RollMan/ac_onoff_controller/README.md

## Appearance
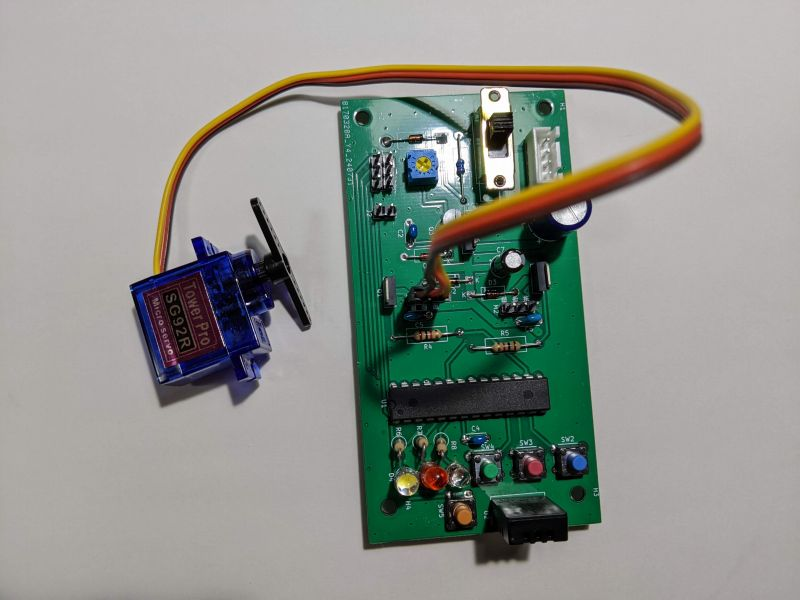
[picture p1: docs/img/board_fig.jpg]
Board appearance


## Improvements
The 2nd servo motor (M2) must be connected to PB2 which is assigned as compare output mode.
