RollMan/ac_onoff_controller/bypass_capacitor.asc

C1: cap; 500µ
I1: current; 0.5
Named nets: 0
.tran 0.01
.ic V(N001) 5
