RollMan/ac_onoff_controller/hardware/ac_onoff_controller/ac_onoff_controller.kicad_pcb

## KiCad design hardware/ac_onoff_controller/ac_onoff_controller.kicad_pcb (2024-07-31)

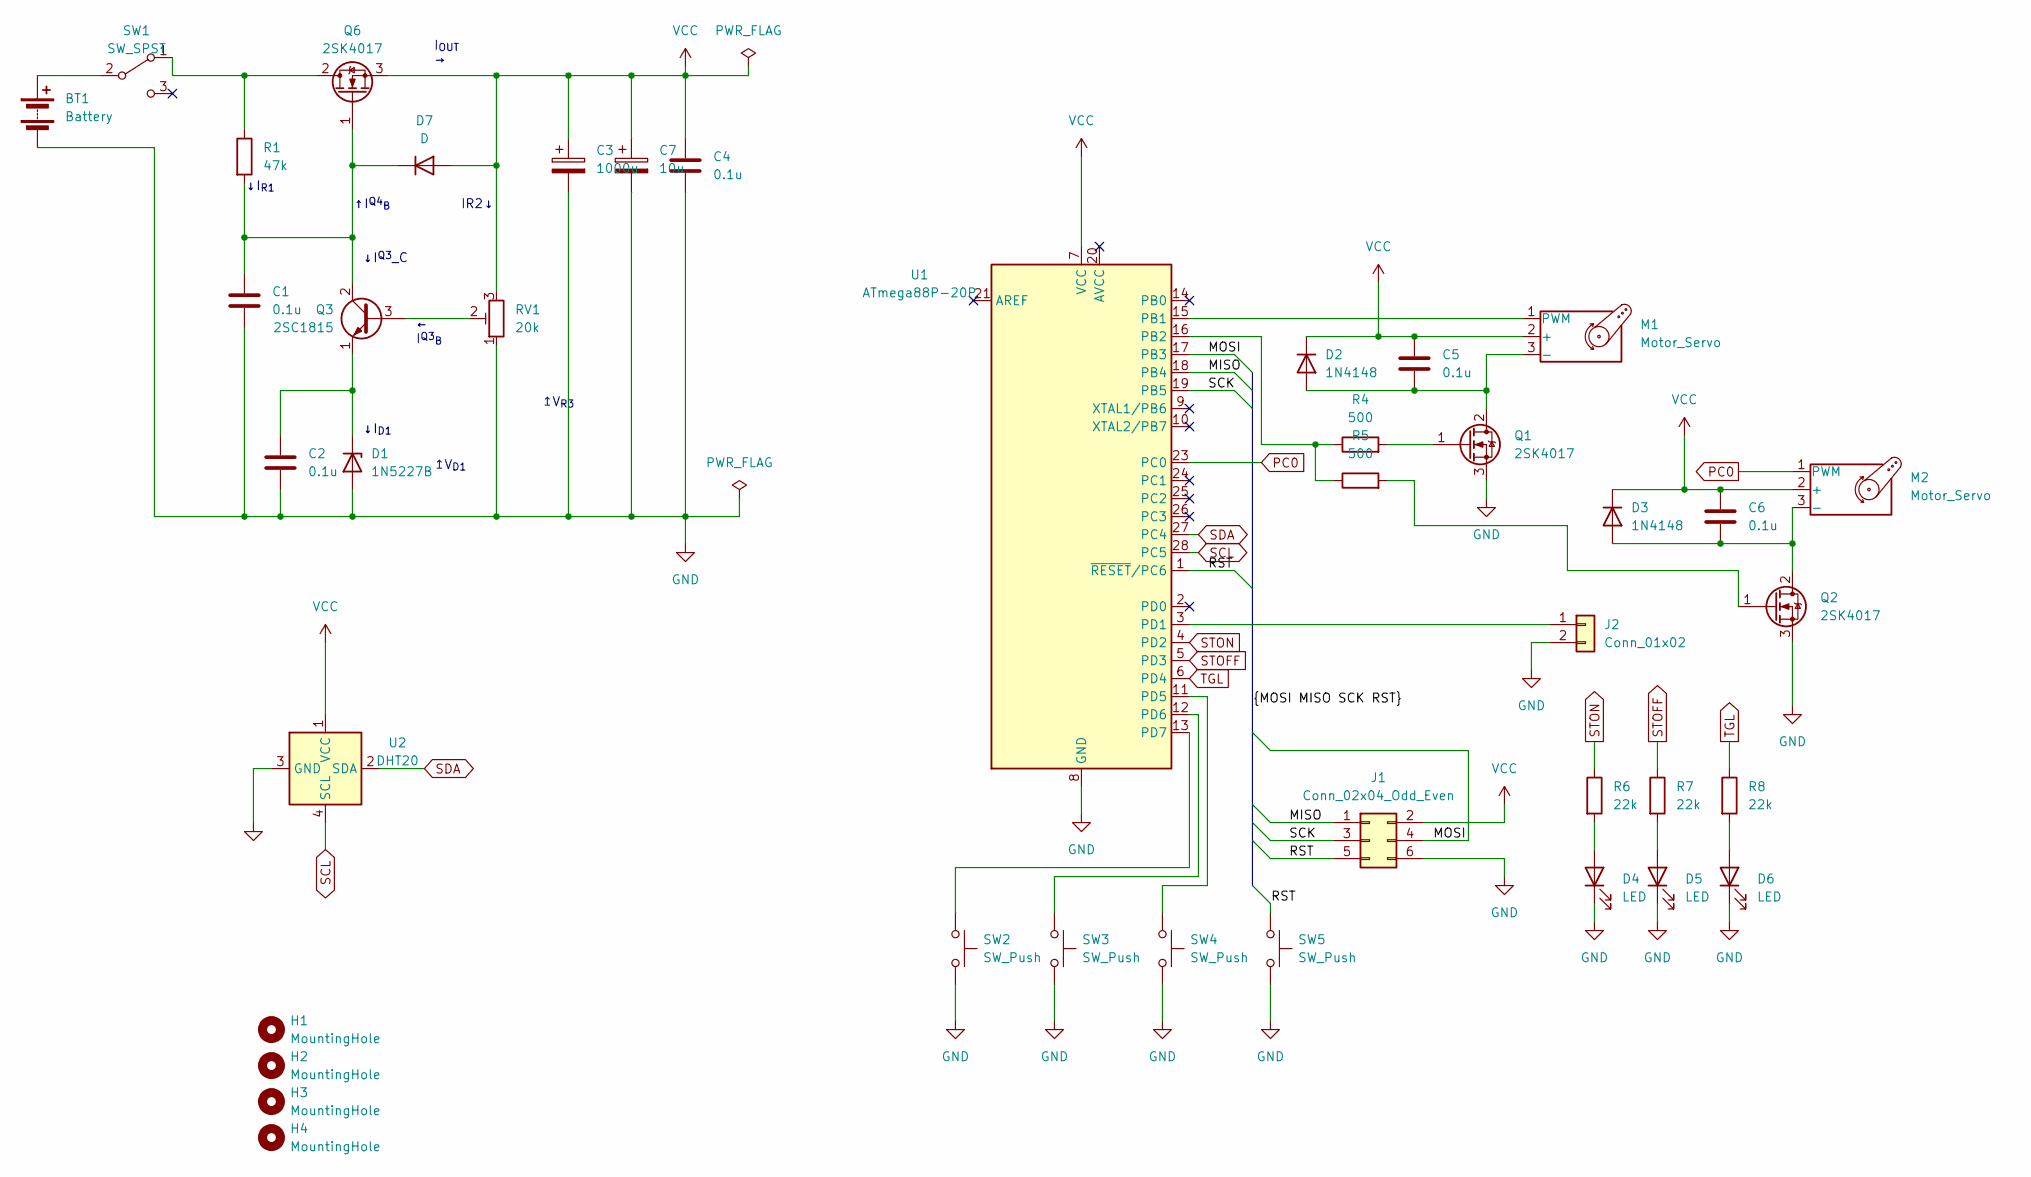
[picture p2: schematic ac_onoff_controller.kicad_sch]

Parts:
BT1: Battery; JST_XH_B4B-XH-A_1x04_P2.50mm_Vertical
C1, C2, C4, C5, C6: 0.1u; C_Disc_D4.3mm_W1.9mm_P5.00mm
C3: 1000u; CP_Radial_D10.0mm_P5.00mm
C7: 10u; CP_Radial_D5.0mm_P2.00mm
D1: 1N5227B; D_A-405_P10.16mm_Horizontal
D2, D3: 1N4148; D_A-405_P10.16mm_Horizontal
D4: LED; LED_D3.0mm; MPN OSDR5113A
D5: LED; LED_D3.0mm; MPN EPY5608S
D6: LED; LED_D3.0mm; MPN NOCODE(WHITE)
D7: D; D_DO-15_P12.70mm_Horizontal
H1, H2, H3, H4: MountingHole; MountingHole_3.2mm_M3
J1: Conn_02x04_Odd_Even; PinHeader_2x03_P2.54mm_Vertical
J2: Conn_01x02; PinHeader_1x02_P2.54mm_Vertical
M1, M2: Motor_Servo; PinHeader_1x03_P2.54mm_Vertical
Q1, Q2, Q6: 2SK4017; TO-251-3_Vertical; MPN 2SK4017(Q)
Q3: 2SC1815; TO-92_Inline_Wide
R1: 47k; R_Axial_DIN0309_L9.0mm_D3.2mm_P15.24mm_Horizontal
R4, R5: 500; R_Axial_DIN0309_L9.0mm_D3.2mm_P15.24mm_Horizontal
R6, R7, R8: 22k; R_Axial_DIN0309_L9.0mm_D3.2mm_P2.54mm_Vertical
RV1: 20k; GF063P
SW1: SW_SPST; SS-22F25-G4; MPN SS-22F25-G4
SW2, SW3, SW4, SW5: SW_Push; SW_PUSH_6mm_H7.3mm
U1: ATmega88P-20P; DIP-28_W7.62mm
U2: DHT20; Aosong_DHT20

Connections:
/MISO: J1.1, U1.18 (PB4)
/MOSI: J1.4, U1.17 (PB3)
/RST: J1.5, SW5.1, U1.1 (~RESET/PC6)
/SCK: J1.3, U1.19 (PB5)
GND: BT1.2 (-), C1.2, C2.2, C3.2, C4.2, C7.2, D1.2 (A), D4.1 (K), D5.1 (K), D6.1 (K), J1.6, J2.2, Q1.3 (S), Q2.3 (S), RV1.1, SW2.2, SW3.2, SW4.2, SW5.2, U1.8 (GND), U1.22 (GND), U2.3 (GND)
unnamed: BT1.1 (+), SW1.2 (B)
unnamed: C2.1, D1.1 (K), Q3.1 (E)
unnamed: C5.2, D2.2 (A), M1.3 (-), Q1.2 (D)
unnamed: C6.2, D3.2 (A), M2.3 (-), Q2.2 (D)
unnamed: D4.2 (A), R6.2
unnamed: D5.2 (A), R7.2
unnamed: D6.2 (A), R8.2
unnamed: C1.1, D7.1 (K), Q3.2 (C), Q6.1 (G), R1.2
unnamed: J2.1, U1.3 (PD1)
unnamed: M1.1 (PWM), U1.15 (PB1)
unnamed: Q1.1 (G), R4.2
unnamed: Q2.1 (G), R5.2
unnamed: Q3.3 (B), RV1.2
unnamed: Q6.2 (D), R1.1, SW1.1 (A)
unnamed: R4.1, R5.1, U1.16 (PB2)
unnamed: SW4.1, U1.11 (PD5)
unnamed: SW3.1, U1.12 (PD6)
unnamed: SW2.1, U1.13 (PD7)
PC0: M2.1 (PWM), U1.23 (PC0)
SCL: U1.28 (PC5), U2.4 (SCL)
SDA: U1.27 (PC4), U2.2 (SDA)
STOFF: R7.1, U1.5 (PD3)
STON: R6.1, U1.4 (PD2)
TGL: R8.1, U1.6 (PD4)
VCC: C3.1, C4.1, C5.1, C6.1, C7.1, D2.1 (K), D3.1 (K), D7.2 (A), J1.2, M1.2 (+), M2.2 (+), Q6.3 (S), RV1.3, U1.7 (VCC), U2.1 (VCC)

Notes on the sheet:
↑I^{Q4}_{B}
IR2↓
↓I_{D1}
↓I^{Q3}_C
I_{OUT} →
↓I_{R1}
↥V_{R3}
← I^{Q3}_{B}
↥V_{D1}

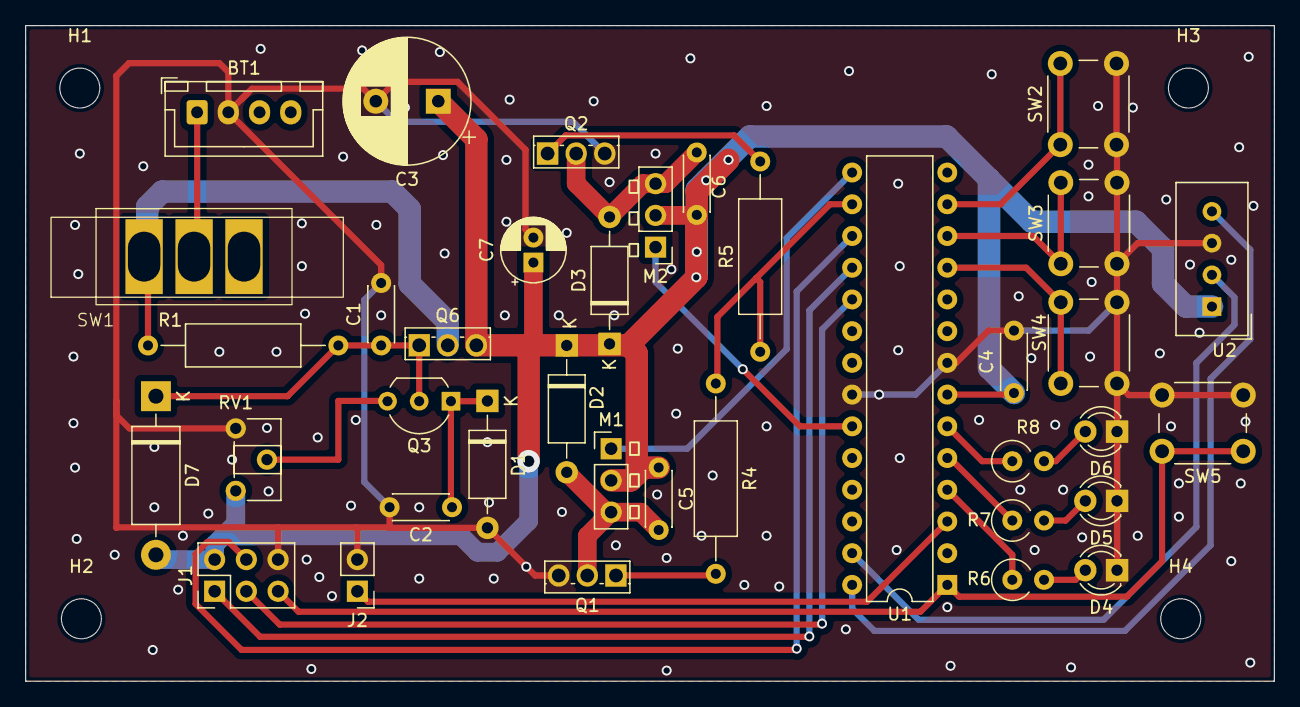
[picture p3: board ac_onoff_controller.kicad_pcb from above]

Board: 2 copper layers, 100.0 x 52.5 mm, 41 parts (0 on the bottom side), 30 nets.
