RollMan/ac_onoff_controller/ac_onoff_controller/util.h

/*
 * util.h
 *
 * Created: 2024/09/05 17:13:55
 *  Author: qwpmb
 */ 


#ifndef UTIL_H_
#define UTIL_H_

#define ABS(val)        val < 0 ? -val : val
#define true (1)
#define false (0)

#endif /* UTIL_H_ */
