RollMan/ac_onoff_controller/(commit log)

2024-07-23 fix pin assigmnents
2024-07-23 add pcb
    [ac_onoff_controller.kicad_pcb, ac_onoff_controller.kicad_sch]
2024-07-23 wip: modify footprints etc. for ordering PCBs
    [ac_onoff_controller.kicad_sch]
2024-07-24 modify footprints etc. for ordering PCBs
    [ac_onoff_controller.kicad_pcb, ac_onoff_controller.kicad_sch]
2024-07-25 wip: add a new pcb design for ordering to vendors
    [ac_onoff_controller.kicad_pcb, ac_onoff_controller.kicad_sch]
2024-07-27 add a new pcb design for ordering to vendors
    [ac_onoff_controller.kicad_pcb, ac_onoff_controller.kicad_sch]
2024-07-30 use trim register for voltage regulator feedback
    [ac_onoff_controller.kicad_pcb, ac_onoff_controller.kicad_sch]
2024-07-30 add mpn of a trim register
    [ac_onoff_controller.kicad_sch]
2024-07-30 add vias
    [ac_onoff_controller.kicad_pcb]
2024-07-30 change via size constraints
    [ac_onoff_controller.kicad_pcb]
2024-07-31 export gerbers for jlcpcb
    [ac_onoff_controller.kicad_pcb, ac_onoff_controller.kicad_sch]
2024-07-31 adjust silkscreen placements
    [ac_onoff_controller.kicad_pcb]
2024-07-31 add the MPN of DHT20
    [ac_onoff_controller.kicad_sch]
2024-09-11 update libraries that supports the new board
2024-09-11 enable buttons on the board to current recognition of A/C power status
2024-09-11 add a board appearance to readme
2024-09-12 supress optimization for a variable used in interruptions
